dvdfreitag/Signal-Detector/README.md

# Signal Detector

## Peripherals

AD8319

The Signal Detector utilizes an Analog Devices [AD8319](http://www.analog.com/en/products/rf-microwave/rf-power-detectors/non-rms-responding-detector/ad8319.html) RF power detector. Power is supplied to the board through the USB Micro B connector. The RF signal input is J2, and the output voltage is J1. Above you see the minimal external passives required to use the AD8319, however this board includes some extra external components so that things like the temperature offset and the output voltage can be changed. This board is configured to use the AD8319 in measurement mode, not in control mode.

## Specs

The AD8319 has a massive input bandwidth of 1MHz to 10GHz, with a dynamic range of 45dB up to 8GHz ( the chip operates to 10GHz, but there is reduced accuracy and dynamic range above 8GHz). The AD8319 operates at a maximum quiescent current of 30mA, and includes automatic internal temperature adjustments with the use of an external resistor. 

AD8319
