dvdfreitag/Signal-Detector/doc/Signal Detector Schematic.pdf

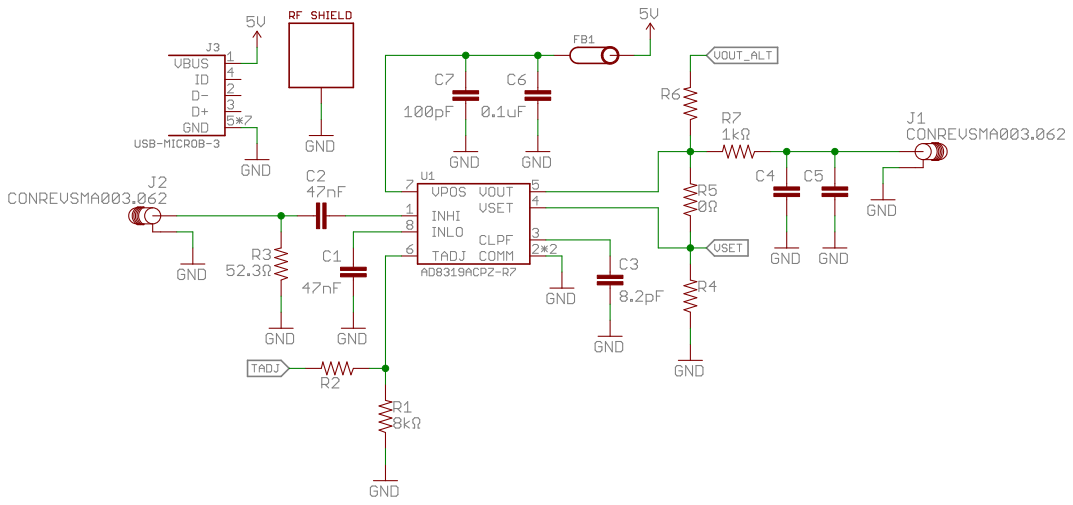
[picture p1: page 1]
