dvdfreitag/Signal-Detector/doc/Signal Detector Board.pdf

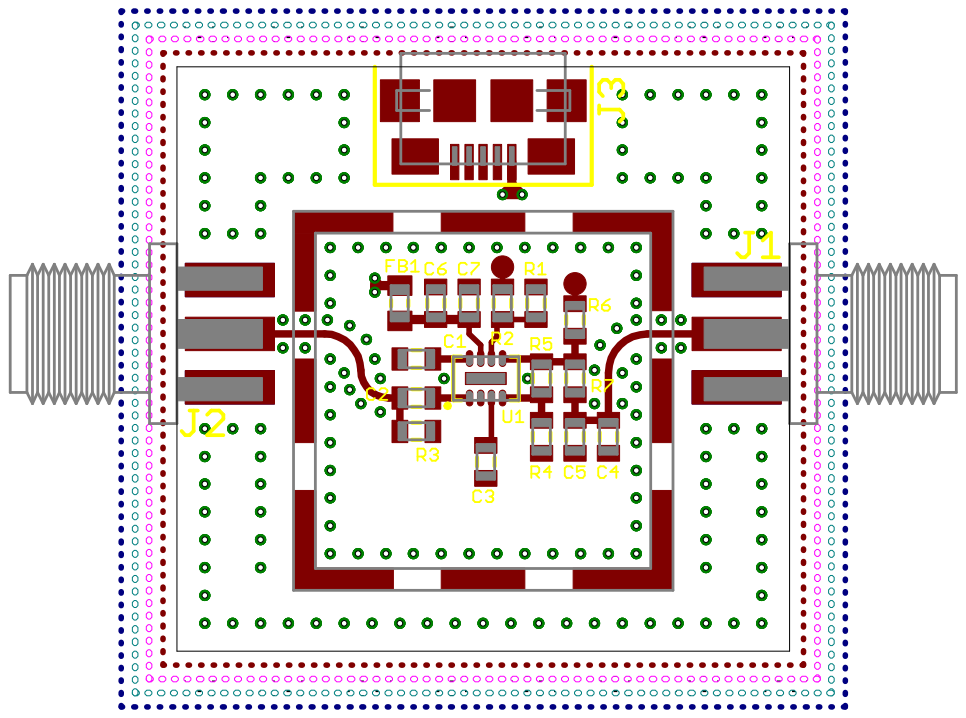
[picture p2: page 1]
