dvdfreitag/Signal-Detector/Signal Detector.brd

## EAGLE design Signal Detector.brd (2016-08-11)

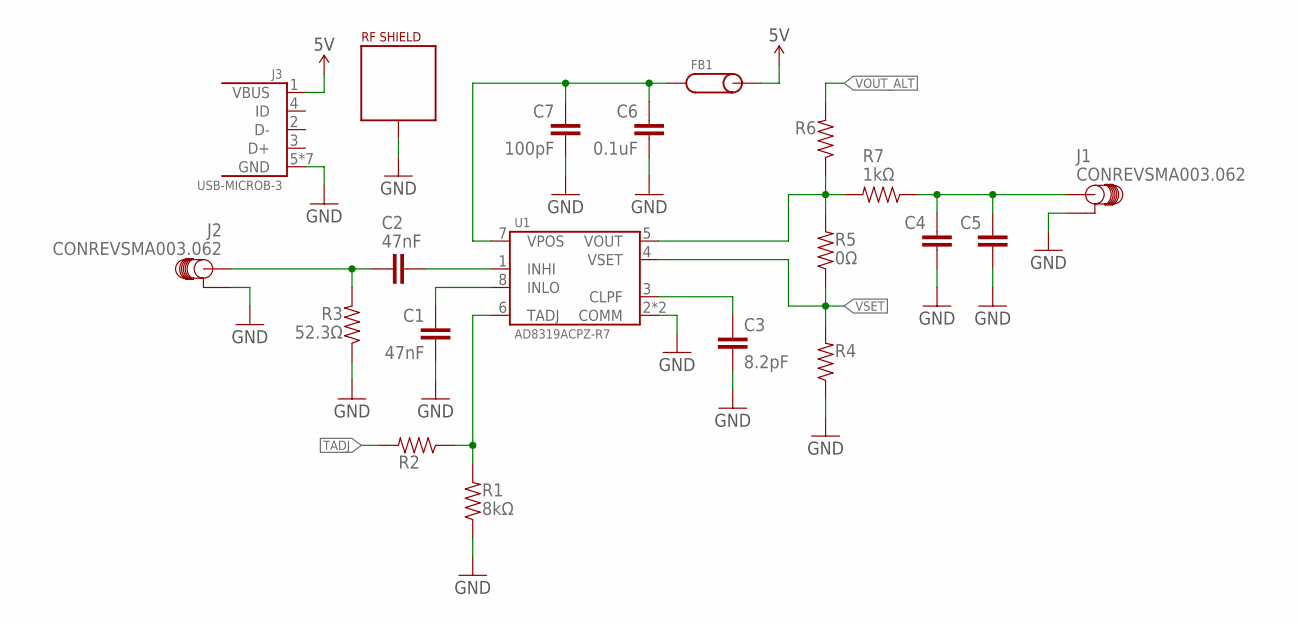
[picture p3: schematic Signal Detector.sch]

Parts:
C1, C2: 47nF; 0603-CAP
C3: 8.2pF; 0603-CAP
C4, C5: CAP-0603; 0603-CAP
C6: 0.1uF; 0603-CAP
C7: 100pF; 0603-CAP
FB1: FERRITE-0603; 0603-FERRITE
J1, J2: CONREVSMA003.062; SMA-EDGE
J3: USB-MICROB-3; 10118192-0001LF
R1: 8kΩ; 0603-CAP
R2, R4, R6: RESISTOR-0603; 0603-CAP
R3: 52.3Ω; 0603-CAP
R5: 0Ω; 0603-CAP
R7: 1kΩ; 0603-CAP
U1: AD8319ACPZ-R7; VFDFN-8-3X2
U$1: RF-SHIELD; RF_SHIELD-.65X.65

Connections:
5V: FB1.P$2, J3.1 (VBUS)
GND: C1.2, C3.2, C4.2, C5.2, C6.2, C7.2, J1.P$1 (GND), J1.P$2 (GND), J1.P$3 (GND), J1.P$4 (GND), J2.P$1 (GND), J2.P$2 (GND), J2.P$3 (GND), J2.P$4 (GND), J3.5 (GND), J3.P$6 (GND), J3.P$7 (GND), J3.P$8 (GND), J3.P$9 (GND), J3.P$10 (GND), J3.P$11 (GND), R1.1, R3.1, R4.1, U1.2 (COMM), U1.PAD (COMM), U$1.P$1, U$1.P$2, U$1.P$3, U$1.P$4, U$1.P$5, U$1.P$6, U$1.P$7, U$1.P$8, U$1.P$9, U$1.P$10, U$1.P$11, U$1.P$12
unnamed: R1.2, R2.1, U1.6 (TADJ)
unnamed: C1.1, U1.8 (INLO)
unnamed: C2.2, J2.SIGNAL, R3.2
unnamed: C2.1, U1.1 (INHI)
unnamed: C3.1, U1.3 (CLPF)
unnamed: R5.2, R6.1, R7.2, U1.5 (VOUT)
unnamed: C4.1, C5.1, J1.SIGNAL, R7.1
unnamed: C6.1, C7.1, FB1.P$1, U1.7 (VPOS)
TADJ: R2.2
VOUT_ALT: R6.2
VSET: R4.2, R5.1, U1.4 (VSET)

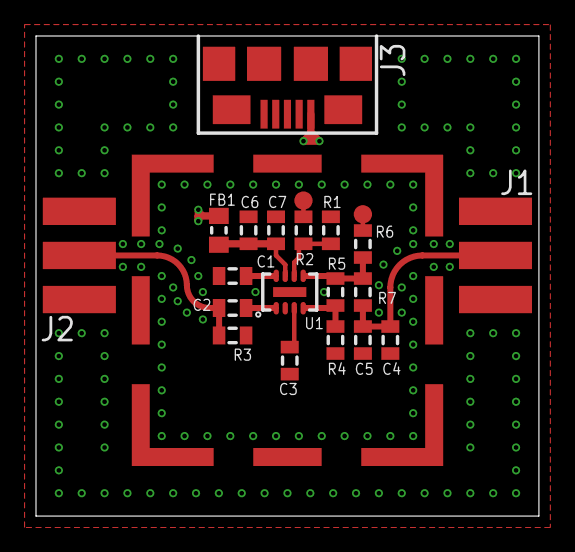
[picture p4: board Signal Detector.brd from above]

Board: 4 copper layers, 27.9 x 26.7 mm, 20 parts (0 on the bottom side), 11 nets.
