dvdfreitag/Signal-Detector/(commit log)

2016-08-11 Added documents
    Added PDF schematic/layout and the datasheet for the AD8319
2016-08-16 Add Kitnic files
    [bom.tsv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]
2016-08-16 Update gerber files
    Removed spaces in filenames in order to support Kitnic
    [Signal-Detector.drills.xln]
